dashpes/ISSMonitor/case/panel_layout.png

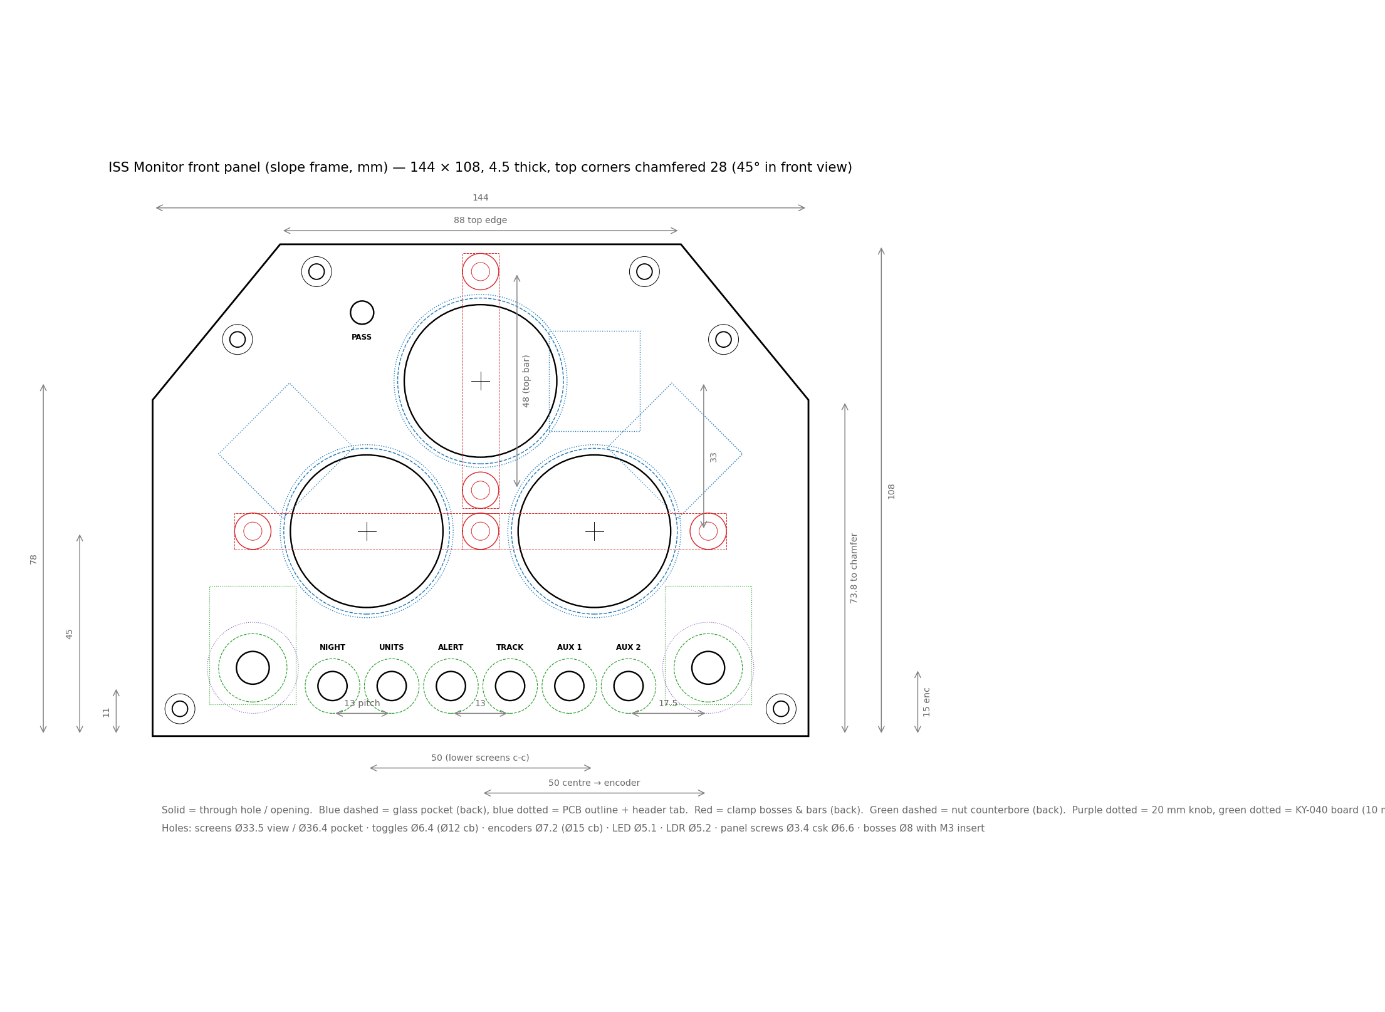
case/panel_layout.png
