dashpes/ISSMonitor/case/previews/clamps.png

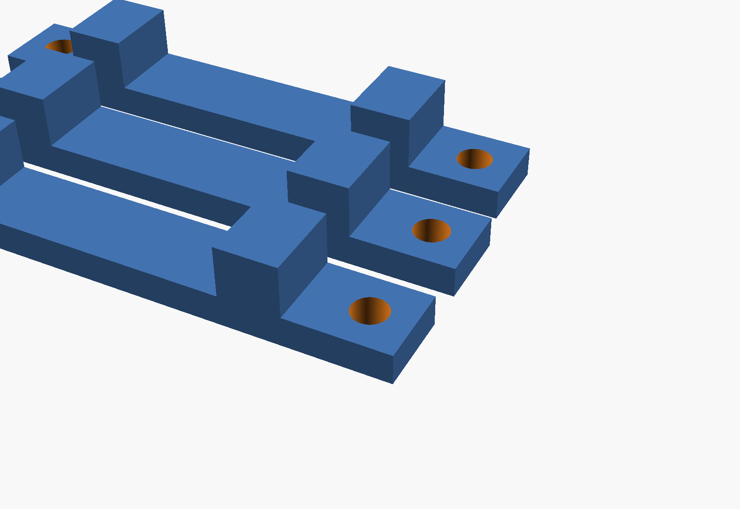
case/previews/clamps.png
