dashpes/ISSMonitor/case/previews/cutaway.png

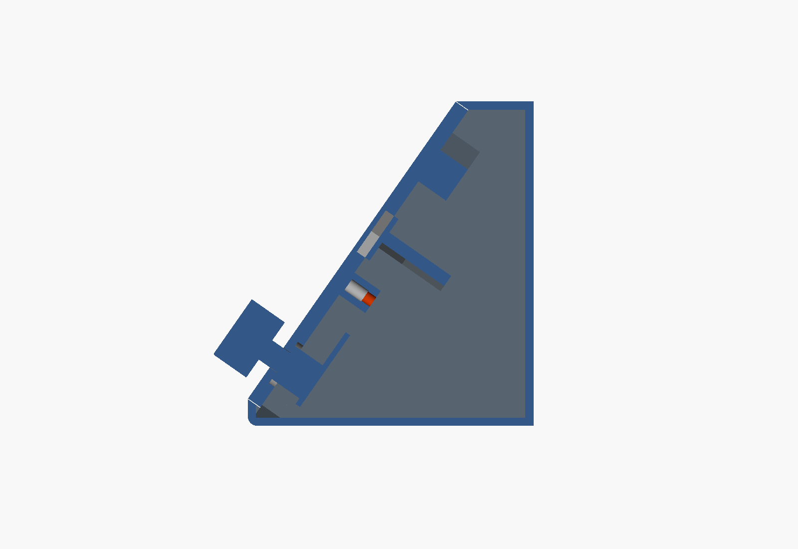
case/previews/cutaway.png
