dashpes/ISSMonitor/case/previews/panel_back.png

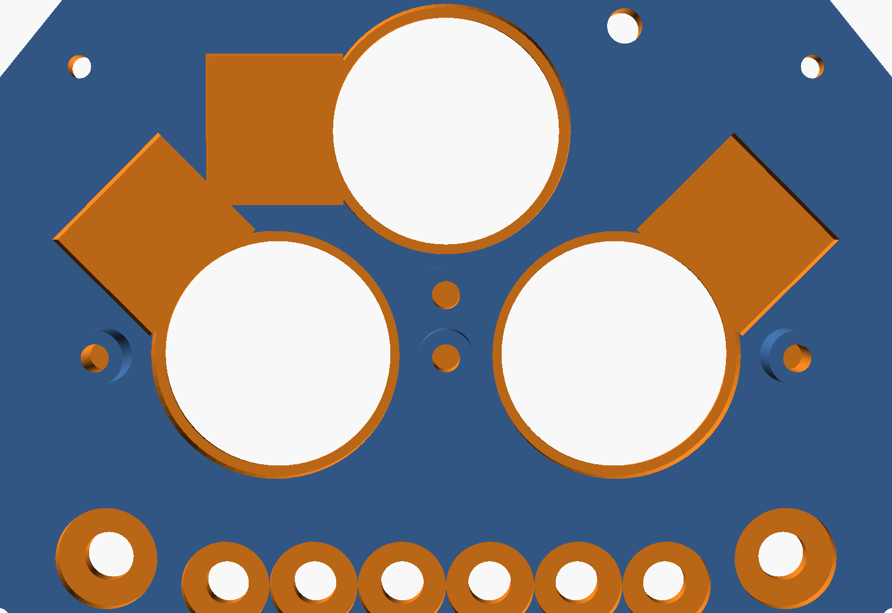
case/previews/panel_back.png
