dashpes/ISSMonitor/case/previews/shell_inside.png

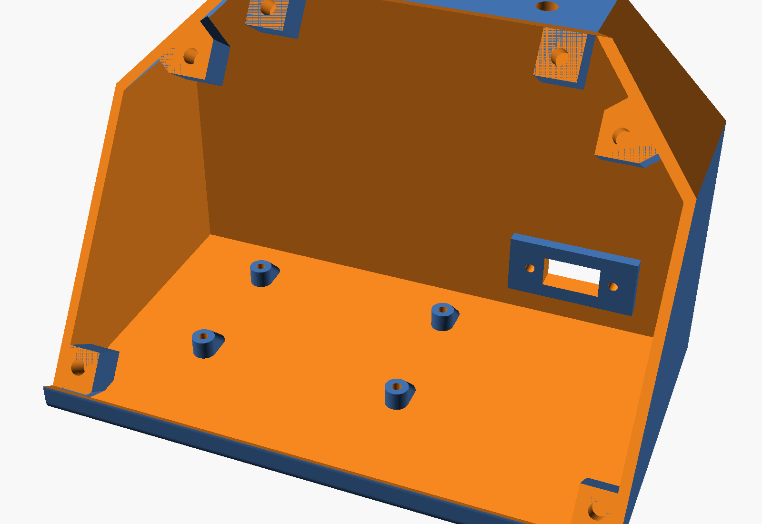
case/previews/shell_inside.png
