dashpes/ISSMonitor/case/previews/v2_shell_inside.png

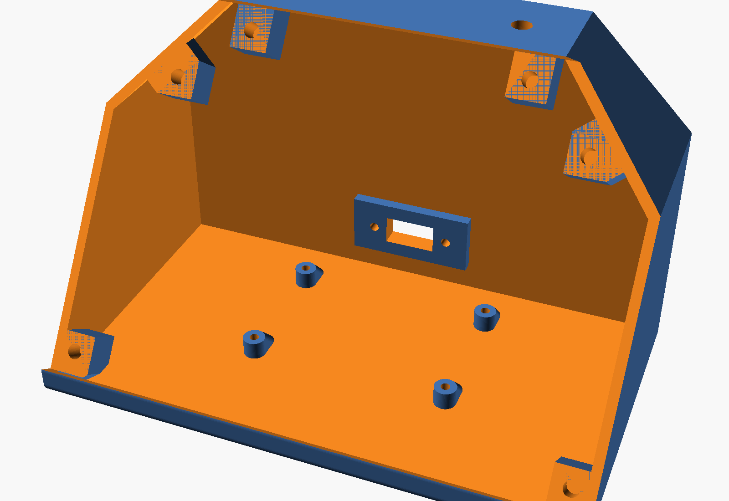
case/previews/v2_shell_inside.png
