dashpes/ISSMonitor/case/stl/ISS_console_shell.stl

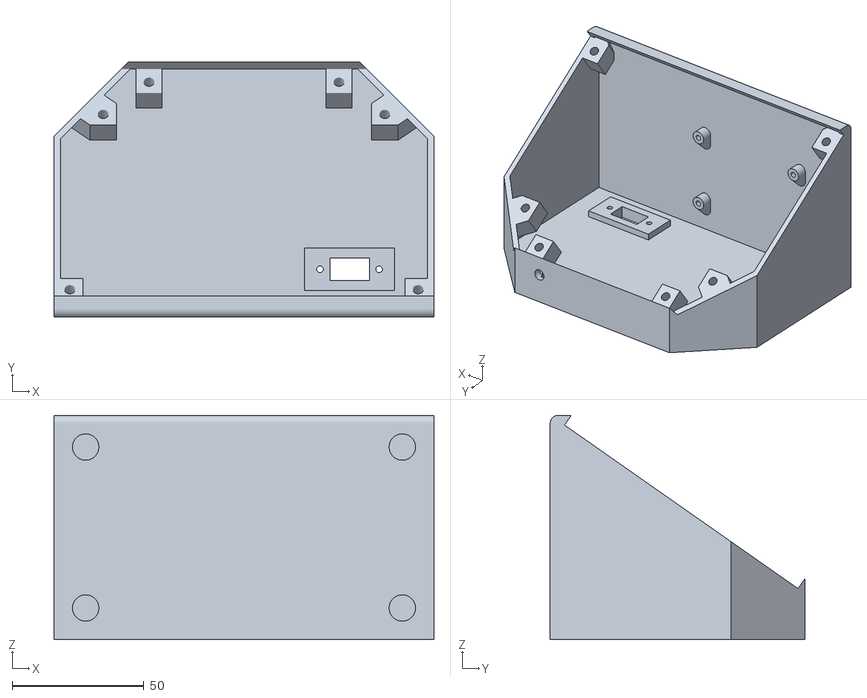
[picture p10: CAD file, 2026-11-06]
case/stl/ISS_console_shell.stl
144.0 x 96.5 x 85.0
