dashpes/ISSMonitor/case/stl/ISS_console_bezel.stl

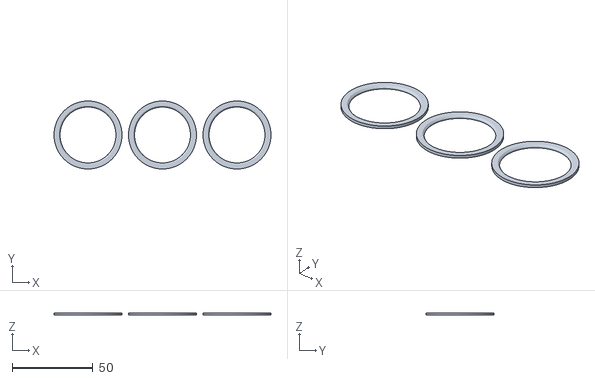
[picture p11: CAD file, 2026-09-17]
case/stl/ISS_console_bezel.stl
134.0 x 42.0 x 1.50
