dashpes/ISSMonitor/case/stl/ISS_console_clamp.stl

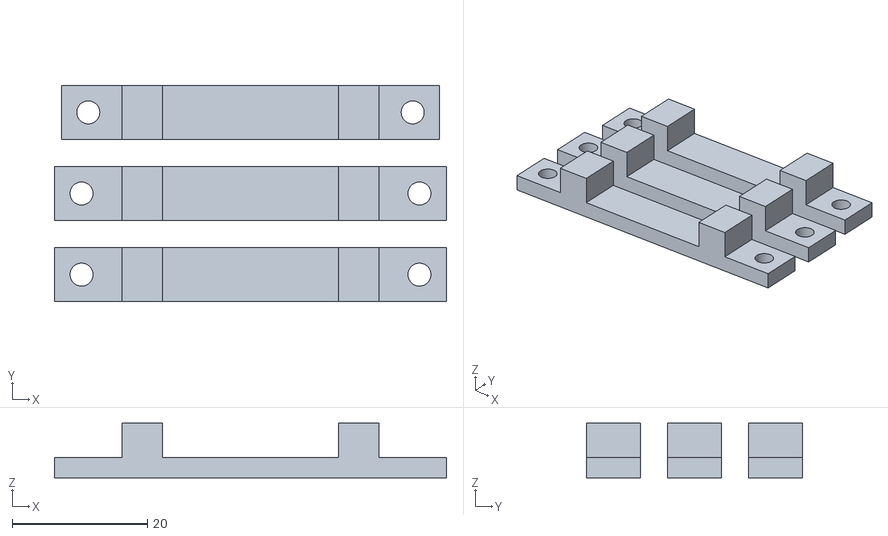
[picture p12: CAD file, 2026-09-17]
case/stl/ISS_console_clamp.stl
58.0 x 32.0 x 8.10
