dashpes/ISSMonitor/case/stl/ISS_console_panel.stl

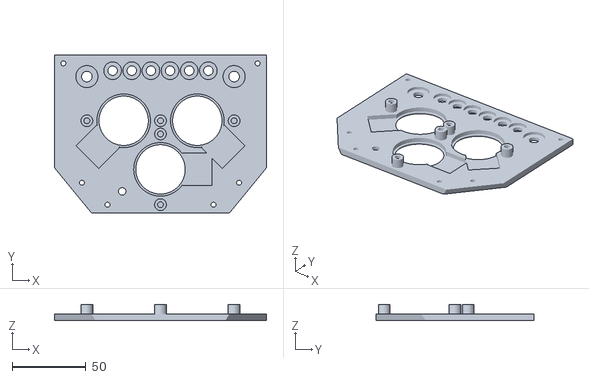
[picture p13: CAD file, 2026-09-17]
case/stl/ISS_console_panel.stl
144.0 x 107.6 x 11.0
