dashpes/ISSMonitor/case/previews/assembly_back.png

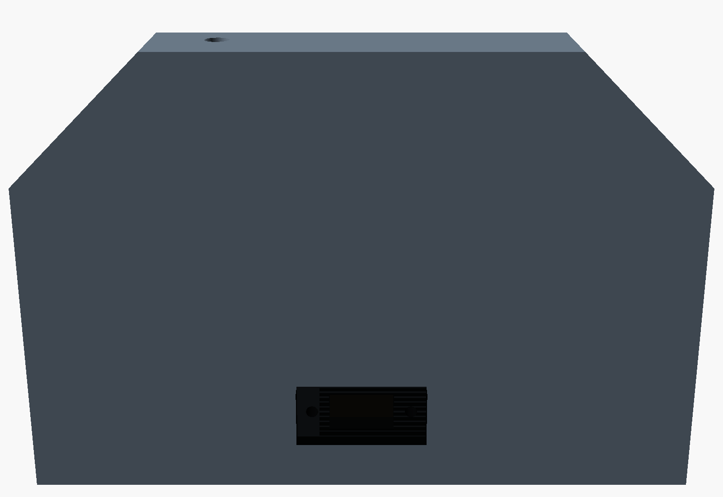
case/previews/assembly_back.png
