dashpes/ISSMonitor/case/previews/assembly_front.png

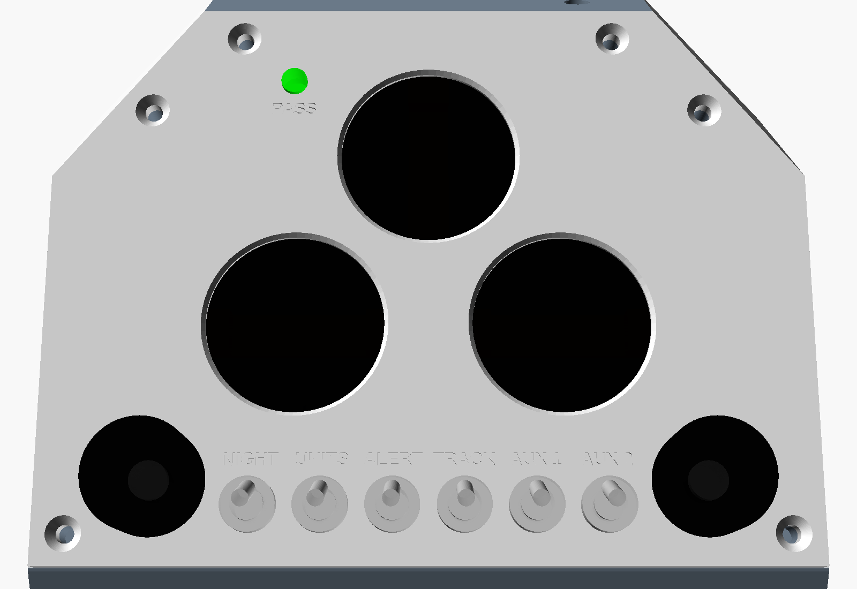
case/previews/assembly_front.png
