dashpes/ISSMonitor/case/previews/panel_print.png

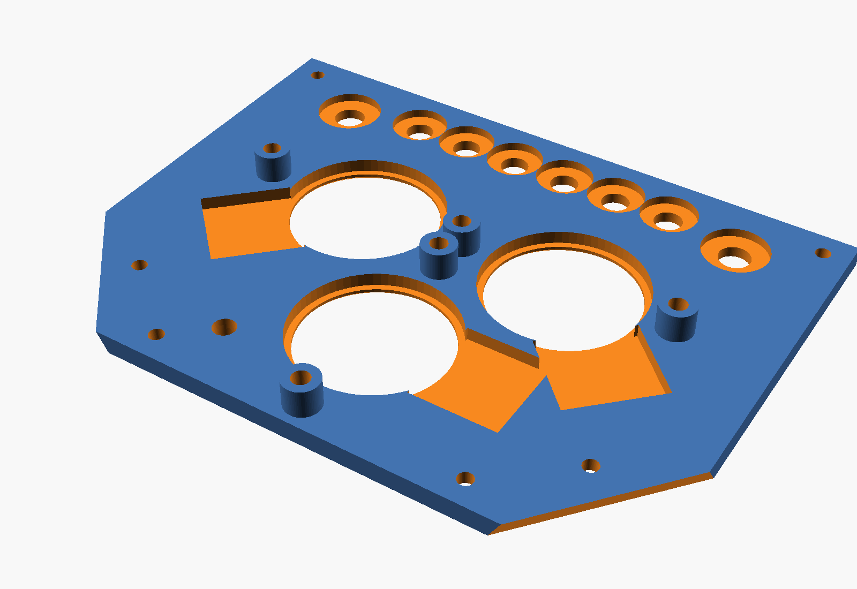
case/previews/panel_print.png
