dashpes/ISSMonitor/case/previews/shell_print.png

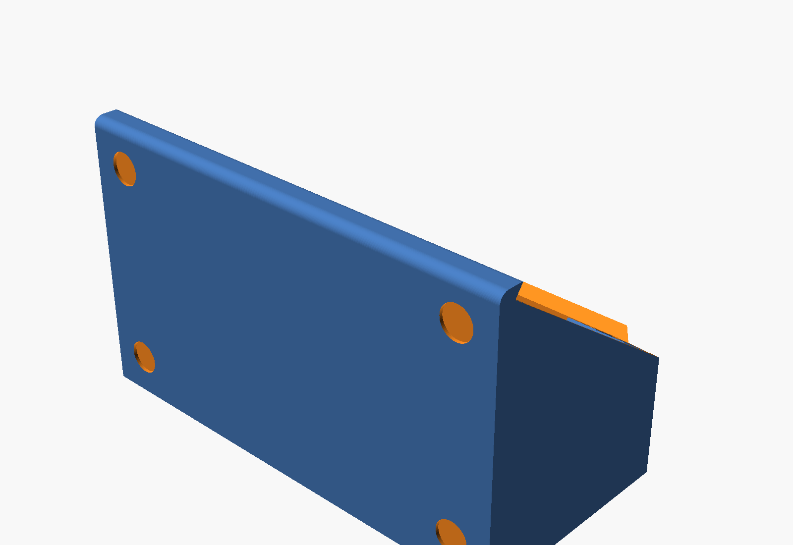
case/previews/shell_print.png
