dashpes/ISSMonitor/firmware/include/config.h

#pragma once
//
// config.h -- every pin number and tunable constant in one place.
// Transcribed from PARTS_LIST.md section 2. If you rewire, change it HERE
// and nowhere else. A magic number that appears in two files is a bug
// waiting to happen.
//
// C++ note: `constexpr` means "compute this at compile time". Unlike the
// Arduino habit of `#define PIN_LED 13`, a constexpr has a real type, obeys
// scope, and shows up in the debugger. Prefer it over #define always.
//
#include <cstdint>

// ---- Which hardware is actually wired up right now ----
// Set from platformio.ini. Defaulted here so the headers stand alone.
#ifndef HAVE_ENCODER
#define HAVE_ENCODER 1
#endif
#ifndef HAVE_LDR
#define HAVE_LDR 1
#endif
#ifndef HAVE_AUX_SWITCHES
#define HAVE_AUX_SWITCHES 1
#endif

// ---- Profiling ----
// Off by default. Turn on for one build without editing anything:
//   PLATFORMIO_BUILD_FLAGS=-DGLOBE_PROFILE=1 pio run -t upload -t monitor
// The globe is the only screen that redraws all 240x240 every tick, so it is
// the only one whose frame cost is worth instrumenting.
#ifndef GLOBE_PROFILE
#define GLOBE_PROFILE 0
#endif

namespace cfg {

constexpr bool kHaveEncoder = HAVE_ENCODER;
constexpr bool kHaveLdr     = HAVE_LDR;
constexpr bool kHaveAuxSwitches = HAVE_AUX_SWITCHES;
constexpr bool kGlobeProfile    = GLOBE_PROFILE;

// ---- Shared SPI bus (all three GC9A01 displays) ----
constexpr uint8_t PIN_SCK  = 18;  // "SCL" on the module
constexpr uint8_t PIN_MOSI = 23;  // "SDA" on the module -- SPI, not I2C
constexpr uint8_t PIN_DC   = 17;  // TX2
constexpr uint8_t PIN_RST  = 16;  // RX2
// NOTE: no backlight pin. The Hosyond modules are the 7-pin type (no BLK),
// so the backlight is always on and D4 is free -- which the case pin plan
// spends on an encoder's DT line. "Night mode" therefore dims by switching to
// the red palette, not by dimming the backlight. If your modules DO have an
// 8th BLK pin, you have a conflict: move that DT line somewhere else.

// ---- Per-display chip select ----
constexpr uint8_t PIN_CS_TELEMETRY = 5;   // left
constexpr uint8_t PIN_CS_GLOBE     = 21;  // center
constexpr uint8_t PIN_CS_SKY       = 22;  // right

// ---- Per-display rotation: degrees CLOCKWISE, as seen from the front ----
// How far each image has to turn to read upright. The modules sit in the
// panel at whatever angle their header tab allows (case/CASE_NOTES.md), so
// these are facts about the case, measured on the bench.
//
// Multiples of 90 are free -- the panel scans its memory in a different
// order. Anything else costs a full-frame sprite rotated in software on every
// push (ui/rotated_frame.h), so keep the odd angles to the screens that
// genuinely need them.
constexpr int ROT_TELEMETRY_DEG = -135;  // left
constexpr int ROT_GLOBE_DEG     =   90;  // center
constexpr int ROT_SKY_DEG       =  135;  // right

constexpr int  SCREEN_W = 240;
constexpr int  SCREEN_H = 240;
constexpr int  SCREEN_R = 120;           // radius, used constantly by the UI
constexpr uint32_t SPI_HZ = 40'000'000;  // start here; drop to 27 MHz if glitchy

// ---- Toggle switches. All INPUT_PULLUP: ON == LOW. ----
// Mapped to where each switch actually sits in the panel, left to right under
// the engraved labels, not to the PARTS_LIST plan: the switches went into the
// panel in a different order, and repinning here beats unscrewing them.
// Measured slot by slot on the bench (hw_check/inputs_check.cpp).
constexpr uint8_t PIN_SW_NIGHT = 32;  // slot 1
constexpr uint8_t PIN_SW_UNITS = 26;  // slot 2
constexpr uint8_t PIN_SW_ALERT = 33;  // slot 3
constexpr uint8_t PIN_SW_TRACK = 25;  // slot 4
constexpr uint8_t PIN_SW_AUX1  = 14;  // slot 5
constexpr uint8_t PIN_SW_AUX2  = 15;  // slot 6; strapping pin, only affects boot-log verbosity

// ---- Rotary encoders (KY-040) -- one under each lower screen ----
// Per case/CASE_NOTES.md. GPIO 34-39 are input-only with no internal pull-up;
// the KY-040 breakout carries its own 10k pull-ups, so that is fine for
// CLK/DT. The push switches are on normal pins and use INPUT_PULLUP.
//
// The two knobs came out mirrored on the perfboard: the LEFT knob is on the
// pins the plan gave the right one, and vice versa. Swapped here rather than
// resoldered -- each knob must drive the screen above it.
constexpr uint8_t PIN_ENC_L_CLK = 35;  // input-only
constexpr uint8_t PIN_ENC_L_DT  = 4;   // freed by the 7-pin displays
constexpr uint8_t PIN_ENC_L_SW  = 19;

constexpr uint8_t PIN_ENC_R_CLK = 36;  // VP
constexpr uint8_t PIN_ENC_R_DT  = 39;  // VN
constexpr uint8_t PIN_ENC_R_SW  = 27;

// ---- Analog / output ----
constexpr uint8_t PIN_LDR = 34;  // ADC1, keeps working with Wi-Fi on
constexpr uint8_t PIN_LED = 13;  // green "ISS OVERHEAD"

// ---- Observer: Los Angeles City Hall. Set these to your location. ----
constexpr double OBS_LAT_DEG =   34.0522;
constexpr double OBS_LON_DEG = -118.2437;
constexpr double OBS_ALT_M   =   93.0;

// ---- Network ----
constexpr char TLE_URL[] =
    "https://celestrak.org/NORAD/elements/gp.php?CATNR=25544&FORMAT=TLE";
constexpr char TZ_STRING[] = "PST8PDT,M3.2.0,M11.1.0";
constexpr char NTP_1[] = "pool.ntp.org";
constexpr char NTP_2[] = "time.nist.gov";

// ---- Timing (milliseconds). Everything in this project is non-blocking; ----
// ---- these are "how often", never "how long to sleep". ----
constexpr uint32_t MS_PROPAGATE   = 1000;              // recompute ISS position
constexpr uint32_t MS_REDRAW      = 100;               // UI tick
constexpr uint32_t MS_INPUT_POLL  = 5;                 // switch scan
constexpr uint32_t MS_LDR_SAMPLE  = 100;               // ADC read + EMA step
constexpr uint32_t MS_TLE_REFRESH = 6UL * 3600 * 1000; // 6 h
constexpr uint32_t MS_DEBOUNCE    = 25;

// ---- Behaviour ----
constexpr double   PASS_MIN_ELEVATION_DEG = 10.0;  // below this, not worth looking
// How far ahead the pass search looks, and how finely it steps while looking.
// The step is the one that matters: an ISS pass is about six minutes end to
// end, so a step longer than that walks straight over whole passes without
// ever seeing them. 60 s has margin; test_passes.cpp sweeps every phase of
// the grid to prove it, and also proves that 600 s does miss.
// Cost is horizon/step calls into SGP4, so 36 h at 60 s is 2,160 of them.
constexpr int32_t  PASS_SEARCH_HORIZON_S  = 36 * 3600;
constexpr int32_t  PASS_COARSE_STEP_S     = 60;
constexpr uint32_t ALERT_LEAD_SECONDS     = 300;   // LED starts 5 min before AOS
// AUX1 turns the LED into a Morse beacon (app/alert.cpp). NA1SS is the ISS's
// own amateur-radio callsign; "CQ DE" is ham for "calling anyone, this is".
// Letters, digits and spaces only. The unit is one dot: 120 ms is 10 words
// per minute, slow enough to read off an LED by eye.
constexpr char     MORSE_BEACON[]         = "CQ DE NA1SS";
constexpr uint32_t MORSE_UNIT_MS          = 120;
constexpr int      LDR_NIGHT_THRESHOLD    = 800;   // calibrate this on the bench
// Hysteresis band. Go dim below the threshold, but do not come back out of
// it until the reading is this much ABOVE the threshold again. Without a gap
// the two palettes chatter back and forth on ADC noise alone -- the ESP32's
// converter wanders several counts at rest, never mind a hand passing over
// the sensor. Roughly 4% of full scale.
constexpr int      LDR_HYSTERESIS         = 150;
// Smoothing, as the reciprocal of the EMA's alpha: ema += (raw - ema) / 8.
// A power of two so the divide is a shift. At MS_LDR_SAMPLE = 100 ms that is
// a time constant of about 0.8 s: slow enough to ignore someone walking
// past the lamp, fast enough that turning the lights off feels immediate.
constexpr int32_t  LDR_EMA_SHIFT          = 3;    // 1/8

}  // namespace cfg
