dashpes/ISSMonitor/(commit log)

2026-09-17 add parts list and wiring diagrams
    three gc9a01 round screens on one spi bus, six toggles, two encoders,
    an ldr and a pass led, all running off the esp32's usb-c.
    wiring_diagram.py regenerates the svg so the pin map and the picture
    can't drift apart.
    [wiring_diagram.py]
2026-09-17 add parametric openscad case
    sloped cockpit panel, 144x85x96, prints as a front panel and a rear
    shell plus three clamp bars. case_notes has the print orientations and
    the measurements still to confirm against real parts.
    [ISS_console.scad, ISS_console_bezel.stl, ISS_console_clamp.stl, ISS_console_panel.stl, ISS_console_shell.stl]
2026-09-17 add platformio project scaffold
    pin map lives in config.h and nowhere else. appstate is the one struct
    every screen reads and only the app layer writes, so screens take a
    const ref and can't corrupt it.
    third party libs are gitignored, lovyangfx alone ships 126mb of cjk
    font tables. vendor_libs.sh pulls them after a clone.
2026-09-17 add orbit math library and tests
    coordinate and tle code with no arduino dependency at all, so it
    compiles and runs on a laptop. 25 tests, with expected values
    generated from a separate python implementation so the two are
    independent.
    run_tests.sh builds it with plain c++ and a vendored unity. no
    platformio, no network, under a second.
2026-09-17 add hardware bring-up sketches
    separate build envs so each one proves a single thing:
    -e led blink and fade. proves the toolchain, the board setting,
    that the usb-c cable carries data, upload and the
    serial monitor
    -e smoketest each display alone then all three, with colour bars and
    an edge-touching ring. catches swapped rgb order, a bad
    panel offset and two panels sharing a cs line
    -e inputs watches the debounce work, prints only on change
    -e data wifi to ntp to celestrak to sgp4, on serial, no screens
    found two real bugs this way. every panel owned the shared rst line so
    init on one reset the others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
    [data_check.cpp, inputs_check.cpp, led_only.cpp, smoketest.cpp]
2026-09-17 add input, network and propagation modules
    table driven debounce for the toggles, 25ms settle. wifi and ntp as a
    state machine rather than a wait loop so the screens keep drawing while
    it connects. tle cached in nvs so there is something to show at boot
    before the network is up, and a failed refresh keeps the stale set
    rather than dropping to nothing.
    console.cpp is a serial stand-in for the encoders until they arrive.
    worth keeping after that as a debug console.
    [alert.cpp, alert.h, console.cpp, console.h, inputs.cpp, inputs.h, lightsensor.cpp, lightsensor.h]
2026-09-17 add the three screen renderers
    left is telemetry with four modes and an arc gauge, centre is the
    globe, right is pass prediction with four modes.
    the globe composites into an 8bpp sprite, 57.6kb. at 16bpp it would be
    115kb, which is more than a third of usable ram and has to coexist with
    the wifi stack. every screen caches what it last drew and returns early
    when nothing visible changed, which is what lets three spi panels share
    one bus and still feel instant.
    main.cpp is one cooperative loop, no delay() anywhere after setup, and
    every interval test is written now - last >= period so it survives the
    millis() rollover.
2026-09-17 fix tle reload being read as a failure
    sgp4's init returns false both for a bad element set and for one it
    already holds, so an unchanged refresh looked like a failure and
    switched tracking off before the screens ever got data. track the
    loaded line1 here instead, and keep the previous fit when a refresh is
    genuinely rejected - a bad tle six hours from now should not take down
    a propagator that is working.
    also note where the build stands and what is still open.
    [propagator.cpp]
2026-09-17 stop the console fighting the panel toggles
    inputs::poll commits night/units/alert/track from the pins every 5ms,
    so the serial keys for those were being overwritten before the next
    frame. two writers to one field and the hardware wins, which is right,
    but the keys looked like they worked and did nothing. they report the
    current state now.
2026-09-18 draw the earth on the globe screen
    the centre screen was a graticule on a blue disc, which reads as a
    wireframe ball and not as the planet. it draws natural earth 110m
    coastlines now, with the land filled in.
    vertices ship as unit vectors rather than lat/lon. lat/lon needs the
    sine and cosine of every vertex every frame, and double trig here is
    software - the fpu is single precision only. makeOrthoView hoists the
    six trig calls that depend on the camera out to once a frame, and each
    vertex is then nine float multiplies and no trig at all.
    the fill runs the projection backwards instead of filling the outlines.
    an outline is a closed curve and a closed curve does not say which side
    of itself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
2026-09-18 clamp the haversine and cover the antipodes
    groundDistanceKm fed asin(sqrt(h)) without bounding h. It is a sum of
    squared sines and cannot exceed 1, but rounding does not know that: for
    two points on opposite sides of the planet it lands on exactly 1, and
    about one antipodal pair in twenty-five overshoots by an ulp. Measured,
    not assumed -- 17,226 of 400,000.
    That is survivable as written, because sqrt rounds a one-ulp overshoot
    back to 1.0 and asin(1.0) is pi/2, so this is not a fix for a fault
    anyone has seen. It is so the function stops depending on that, in a
    call that runs once a second and whose NaN would reach the telemetry
    screen without throwing or warning.
    The test covers the deg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
2026-09-18 write the encoder ISR and the light sensor
    Both were waiting on parts that are still in the post. The parts gate
    running this code, not writing it, and leaving two files stubbed was
    gating more than it needed to.
    inputs.cpp part B decodes quadrature in an ISR: four quarter-steps to a
    KY-040 detent, a 16-entry table, and the physically impossible
    both-pins-moved transitions scored zero, which is the whole of the
    debouncing. The push switches stay in poll() with the toggles, because
    a detent is an event you cannot miss and a button is a level you
    sample, and only one of those needs an interrupt.
    quarters is read-modify-written from both the ISR and the main loop, so
    draining it takes the spi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
2026-09-18 predict passes with our own search, not Sgp4's
    computePasses called Sgp4::nextpass, which has the same shape of
    problem as init(): one return value for more than one question, and a
    'lighted' flag that is the library's own idea of visibility with no way
    to check it from here. orbit::findPasses is testable on the laptop,
    which nextpass is not.
    Cross-checked before switching, against the real ISS from a live
    Celestrak element set, both implementations run side by side over the
    same 36 hours. Same seven passes, max elevation equal, and the moment
    of maximum agreeing to the second. Azimuth differs by up to 3 degrees,
    which is lookAngle's spherical Earth against the library's ellipsoid,
    as docum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
    [propagator.cpp]
2026-09-18 bring the README up to date
    The console key table never matched console.cpp -- it listed bracket
    keys and ENTER for the knobs, where the code has used 1/2 and 3/4 since
    the two-encoder pin map landed.
    Also: the open list, which is down to hardware verification and one
    dropped item; the write-order table, now a read-order table; and the
    test count, 64.
2026-11-06 repin the switches and knobs to match the build, and turn them on
    The switches went into the panel in a different order from the parts
    list, and the two knobs came out mirrored on the perfboard. Repinning in
    config.h beats unscrewing switches and resoldering, so the map now
    describes the unit on the bench rather than the plan. Each knob has to
    drive the screen above it.
    The parts that were in the post are in, so HAVE_ENCODER, HAVE_LDR and
    HAVE_AUX_SWITCHES all go to 1. inputs_check learns to report the knobs
    and the LDR, and sampling the LDR there is deliberate: ADC1 reads glitch
    GPIO 36/39 (errata 3.11), so the check runs under the main firmware's
    conditions. main.cpp logs one line per kno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
    [config.h, inputs_check.cpp, main.cpp]
2026-11-06 add pin_probe and leak_check for faults a beep test misses
    pin_probe drives every display signal at its own PWM duty, so a
    multimeter on DC volts at the header shows which ESP32 pin each wire
    really reaches. It needs no panel init, which is the point when a screen
    stays blank and the smoke test cannot say why.
    leak_check is for NIGHT flickering in step with the knob on D35. A hard
    short is ruled out, since the knob still counts with NIGHT held on, and
    that leaves a partial one of tens of kilohms. Driving D32 low and
    reading CLK and DT on the ADC turns that into a measurable sag against
    the 10k pull-up. It only ever drives D32 low: driving it high with the
    switch on would short the pin to gr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
    [leak_check.cpp, pin_probe.cpp]
2026-11-06 draw the lower screens at 135 degrees so they read upright
    The two lower modules sit in the panel turned 135 degrees, the only way
    their header tabs fit. Quarter turns are free through setRotation; the
    leftover 45 is not, because LovyanGFX only rotates by an arbitrary angle
    while copying an image. So those screens now draw into a full-frame
    sprite that gets pushed rotated, with bilinear filtering since nearest
    neighbour breaks up the 6x8 font at 45 degrees.
    Memory set the shape of it. 240x240 at 16 bpp is 115 kB against a
    largest free block of about 55 kB, so the frames are 4-bit palette at
    28.8 kB each. The globe had to drop from 8 to 4 bits as well: at 8, the
    HTTPS fetch of the TLE had to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
2026-11-06 add the morse beacon constants
    MORSE_BEACON and MORSE_UNIT_MS, for AUX1 turning the LED into a beacon
    that calls CQ as NA1SS at 10 words per minute.
    Constants only. The comment points at app/alert.cpp, but nothing reads
    these yet, so AUX1 does not do this.
2026-11-06 move the usb-c mount clear of the perfboard
    The panel-mount connector sat on centre, where its body and cable fight
    the perfboard. It moves 40 mm right, and the board moves 18 mm left with
    the ESP32's port at its right edge, facing the side wall. The mock now
    draws the plug, the cable and the mount body so the clearance is visible
    in the preview.
    Cutout and screw spacing come from the real connector: a 15 x 8.5 cutout
    for a body about 14.4 wide, 22.4 mm between holes, and 2.5 mm holes that
    M3 threads straight into.
    STL and previews committed as they stood. They were not regenerated from
    this .scad for this commit. No test print of this revision is recorded.
    [ISS_console.scad, ISS_console_shell.stl]
2026-11-12 ignore the scratch exports folder and the r history file
    Claude outputs/ holds a shell STL and a floor layout render. The STL is
    byte-identical to case/stl/ISS_console_shell.stl (same SHA-256), and the
    render matches case/previews/floor_layout.png pixel for pixel to the
    eye; the committed copy only carries extra metadata. Nothing in there
    is new, so it stays local. .Rhistory is an empty R session file.
    secrets.h was already covered here and in firmware/.gitignore, and has
    never been tracked: git log --all on the path is empty.
2026-11-12 add the mit license
    Covers the firmware, the case model and the scripts. Nothing in the
    repo asked for anything else.
    Third-party code keeps its own terms. The vendored Unity files in
    firmware/test/unity_vendor/ are MIT and carry their own header.
    LovyanGFX and Sgp4 are not committed; vendor_libs.sh fetches them under
    their own licences. The coastline and land mask tables are generated
    from Natural Earth, which is public domain.
2026-11-12 add a readme
    The repo had no front page. A stranger landing on it could not tell
    what the console is, what each screen shows, or where to start.
    It covers the three screens mode by mode, the controls and the PASS LED
    rules, the data pipeline from Celestrak to the screens, a short parts
    summary and a quick start. Every behaviour in it is read from the code,
    not from the parts list plan: the LED thresholds from alert.cpp, the
    gauge ranges from telemetry_screen.cpp, the visibility rule from
    passes.cpp. Written in Simplified Technical English with a glossary for
    TLE, SGP4, AOS/LOS and the rest.
    The images are the existing renders and the generated globe preview.
    There is no photo of the built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
2026-11-12 add the build guide
    docs/build.md is the hardware half: one bill of materials merged from
    PARTS_LIST.md and CASE_NOTES.md, the pin map, the three small circuits,
    the perfboard, per-STL print notes, and a numbered assembly procedure
    with the bring-up sketches slotted in where they catch faults.
    The pin map comes from config.h, not from the wiring diagram. The
    diagram shows the first plan; the built unit moved UNITS, ALERT and
    TRACK and swapped the two knobs. The guide says so next to the diagram
    rather than regenerating it.
    STL sizes are measured from the files: panel 144 x 107.6, shell
    144 x 96.5 x 85. The shell STL is the current one: about 99% of its
    vertices match a fresh OpenSCAD rende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
2026-11-12 add the firmware guide
    docs/firmware.md is the software half: the module map and data flow,
    the flash procedure with secrets.h, every setting in config.h with its
    default, both ways to run the tests, the six hw_check environments with
    the result each one should give, the serial console keys, and how to
    regenerate the globe tables.
    The troubleshooting section is built from problems this unit actually
    hit, as recorded in the git log and the dev log: floating chip selects,
    the shared reset, the brownout, the NIGHT leak on D32, the 45 degree
    fallback when a frame buffer will not allocate, and the TLE reload
    that looked like a failure. Real serial lines go in code fences.
    Verified on this machi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
2026-11-12 bring the parts list and case notes in line with the build
    Both files still described the plan. The switches went into the panel
    in a different order and the knobs came out mirrored, and config.h was
    repinned to match in 173745e, but the tables here were not. The last
    case commit also moved the USB-C mount without touching the notes.
    Pin tables now follow config.h, with the diagram's old pin in brackets
    where they differ. The USB-C cutout, screw spacing and position follow
    the .scad. The case size line said 190 x 95 x 92 at 30 degrees; the
    model is 144 x 85 x 96.5 at 35. The three-position selector and the
    Arduino IDE setup are marked as superseded rather than deleted, since
    D27 and D19 now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
2026-11-12 mark the firmware readme as the development log
    It reads as a dated log, and parts of it are now out of date: it still
    says HAVE_ENCODER and HAVE_LDR are 0 and the parts are on order. A note
    at the top says what it is and points to the current guides. The log
    itself is unchanged.
2026-11-12 license the case files under cc by 4.0
    The case is a design, not code, and CC BY fits it better than MIT:
    anyone can print, remix and sell it as long as they credit the source.
    Everything under case/ moves to CC BY 4.0, including panel_drawing.py,
    since it only exists to produce the panel drawing. The firmware,
    scripts and docs stay MIT.
    case/LICENSE carries a short notice and the full legal code, taken
    unmodified from creativecommons.org/licenses/by/4.0/legalcode.txt.
    LICENSE gains two lines at the top that scope it to everything outside
    case/, and the README license section says which applies to what.
    Those two lines may stop GitHub from detecting LICENSE as plain MIT in
    the sidebar. Mov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
2026-11-12 document the usb-c connector as hot-glued
    The built unit holds the panel-mount USB-C connector in the back-wall
    cutout with hot glue. The screws were never fitted. The docs described
    a two-screw flange mount and asked for a screw length that does not
    exist.
    The build guide now glues it, with a caution to keep glue out of the
    socket. The .scad still has the 22.4 mm flange holes, so the guide and
    the case notes keep them as an option rather than pretending they are
    not there. The bill of materials swaps the two M3 screws for hot glue.
2026-11-12 describe the build as it is and drop the settled questions
    The repo is the finished project. Where a doc disagrees with config.h
    or the .scad, the code is right, so the docs no longer ask which one is
    current. Gone: the questions about the intended ground track length,
    a test print of the current shell, and the calibrated LDR threshold.
    The ground track is described as it behaves: 90 positions a second
    apart, so 90 seconds of orbit. The notes on WIRING_DIAGRAM.png and
    PERFBOARD_LAYOUT.png are cut down to one line each: an earlier plan,
    config.h or the model is the authority. The images are unchanged.
    Still open, and still marked TODO: a photo of the built unit, supplier
    links and costs, an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
2026-11-12 keep the license file plain mit so github detects it
    The two scope lines at the top of LICENSE stop GitHub's licensee from
    matching the file as MIT, so the sidebar shows no license. The README
    license section already says that case/ is under CC BY 4.0 and the
    rest is MIT, and case/LICENSE carries the CC text, so the scope note
    in LICENSE adds nothing.
2026-11-12 move the default observer to los angeles city hall
    The repo is public now, and the observer default was the build's own
    location. config.h now ships Los Angeles City Hall (34.0522,
    -118.2437, 93 m) as a neutral default that anyone changes to their
    own coordinates. The comments in state.h and telemetry_screen.h say
    "the observer" instead of naming the town.
    The geo tests used the same point as fixture data, so they move too.
    The new expected values come from the orbit library itself: a scratch
    program reproduced the old values exactly (33.659 deg, 711.090 km for
    the due-north look) before giving the new ones. The overhead and
    due-north cases do not change, because the model is spherical and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
    [config.h, state.h, telemetry_screen.h]
